jonasnic/Dreimaskin-ELS/HW/ELS_PCB/Freecad/Assembly-Back.step

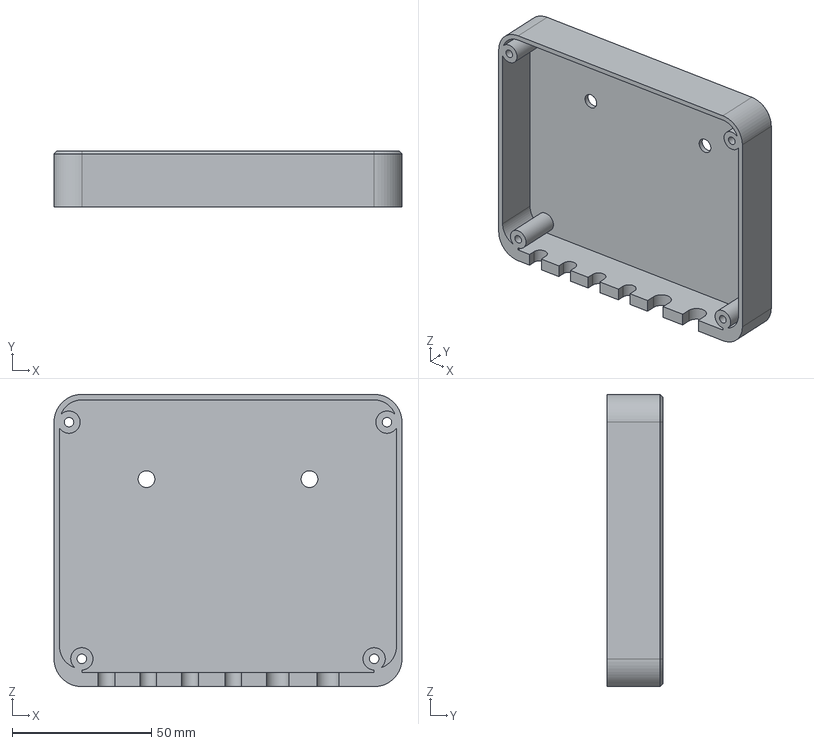
[picture p1: CAD file, 2026-05-08]
HW/ELS_PCB/Freecad/Assembly-Back.step
125.0 x 20.0 x 105.0 mm
