jonasnic/Dreimaskin-ELS/HW/ELS_PCB/Freecad/Assembly.FCStd

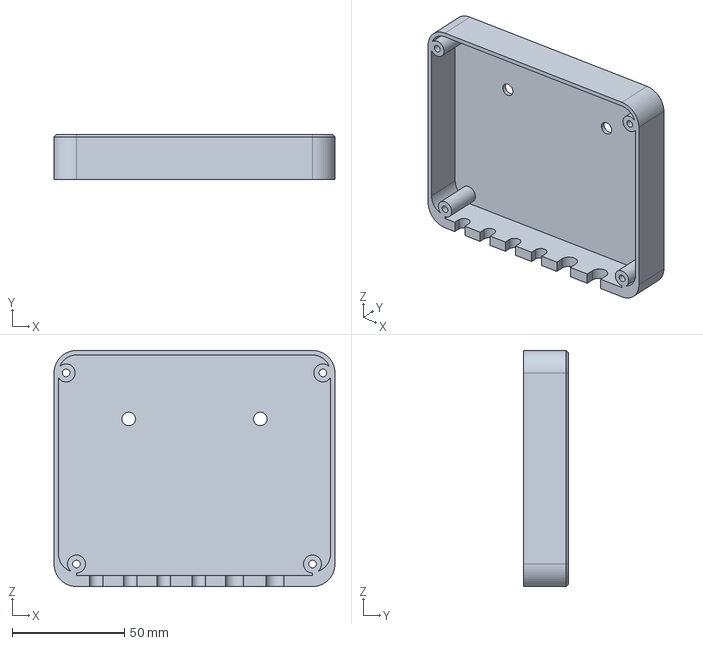
[picture p2: CAD file, 2026-05-08]
HW/ELS_PCB/Freecad/Assembly.FCStd
125.0 x 20.0 x 105.0 mm
