jonasnic/Dreimaskin-ELS/HW/ELS_PCB/Freecad/ELS_project-AssemblyBack001.step

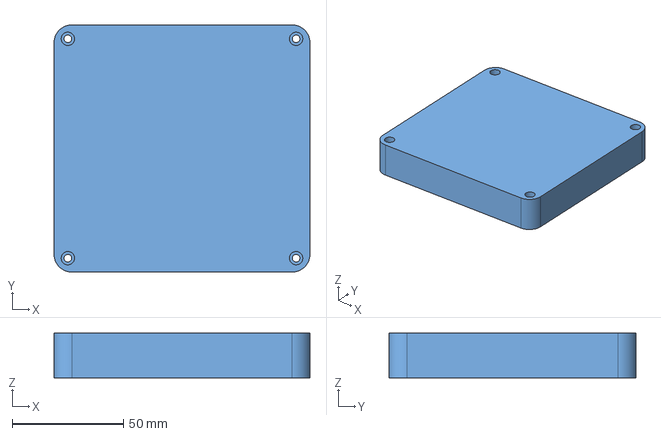
[picture p3: CAD file, 2026-05-03]
HW/ELS_PCB/Freecad/ELS_project-AssemblyBack001.step
115.0 x 111.0 x 20.0 mm
