jonasnic/Dreimaskin-ELS/HW/ELS_PCB/Freecad/ELS_project-AssemblyFrontPanel001.step

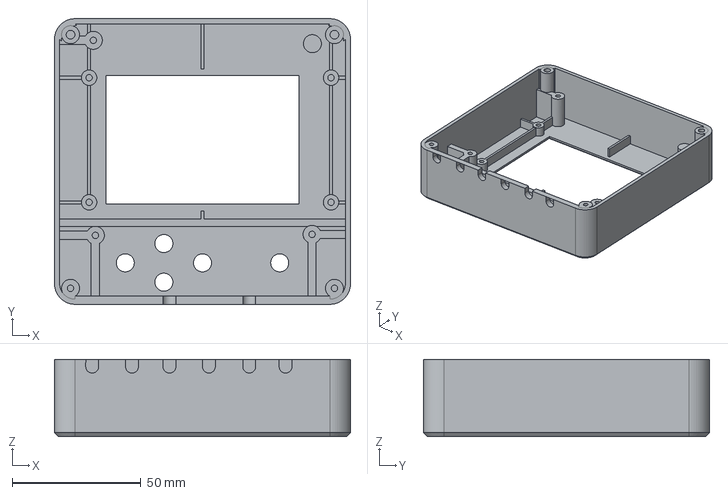
[picture p4: CAD file, 2026-05-03]
HW/ELS_PCB/Freecad/ELS_project-AssemblyFrontPanel001.step
115.0 x 111.0 x 30.0 mm
