jonasnic/Dreimaskin-ELS/HW/ELS_PCB/Freecad/ELS_frontv2.step

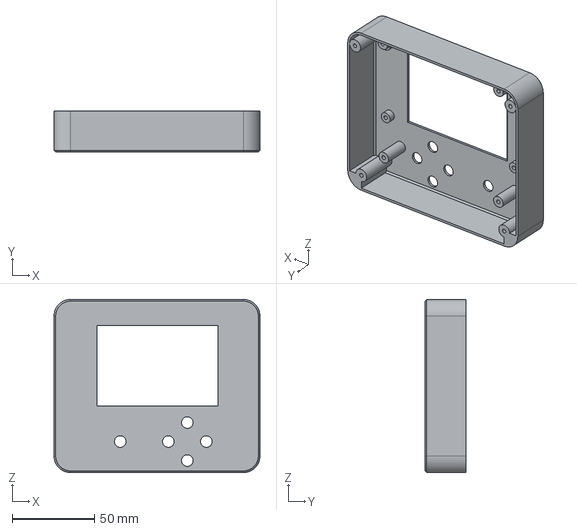
[picture p5: CAD file, 2026-05-08]
HW/ELS_PCB/Freecad/ELS_frontv2.step
125.0 x 25.0 x 105.0 mm
