jonasnic/Dreimaskin-ELS/HW/ELS_PCB/Freecad/ELS_project.FCStd

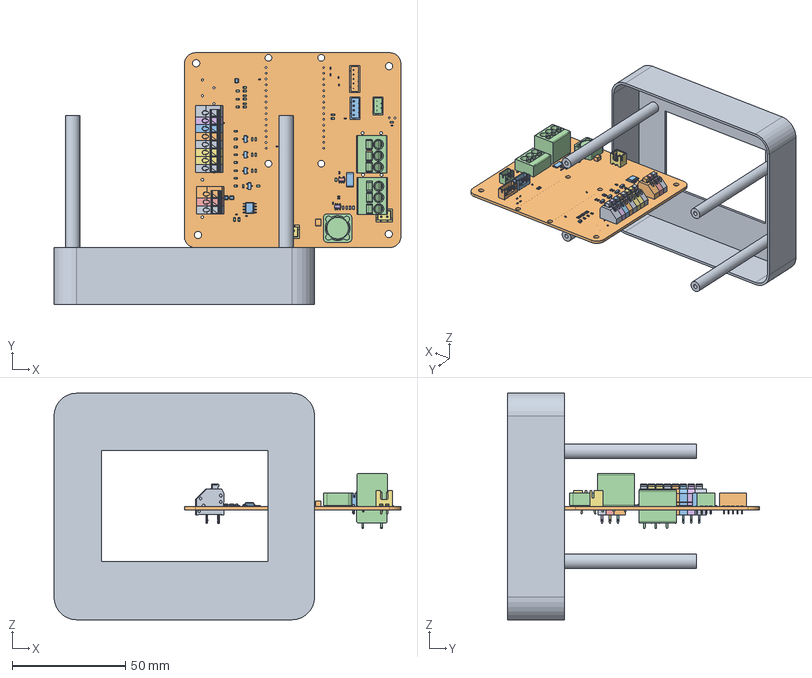
[picture p6: CAD file, 2026-05-08]
HW/ELS_PCB/Freecad/ELS_project.FCStd
153.1 x 111.1 x 100.0 mm
FrontV2
Pcb_7c6a
Q3_SOT-23_f06b826d621a x 4
R6_R_0603_1608Metric_a80c63da43e1 x 31
C1_C_0402_1005Metric_a31eb2e6799d x 12
CONN-TH_8P-P3.50-LS5.10_MX250-3.5-08P-B-GY01-CU-A
CONN-TH_8P-P3.50-LS5.10_MX250-3.5-08P-B-GY01-CU-A001
CONN-TH_8P-P3.50-LS5.10_MX250-3.5-08P-B-GY01-CU-A002
CONN-TH_8P-P3.50-LS5.10_MX250-3.5-08P-B-GY01-CU-A003
CONN-TH_8P-P3.50-LS5.10_MX250-3.5-08P-B-GY01-CU-A004
CONN-TH_8P-P3.50-LS5.10_MX250-3.5-08P-B-GY01-CU-A005
CONN-TH_8P-P3.50-LS5.10_MX250-3.5-08P-B-GY01-CU-A006
CONN-TH_8P-P3.50-LS5.10_MX250-3.5-08P-B-GY01-CU-A007
CONN-TH_8P-P3.50-LS5.10_MX250-3.5-08P-B-GY01-CU-A008
CONN-TH_8P-P3.50-LS5.10_MX250-3.5-08P-B-GY01-CU-A009
CONN-TH_8P-P3.50-LS5.10_MX250-3.5-08P-B-GY01-CU-A010
CONN-TH_8P-P3.50-LS5.10_MX250-3.5-08P-B-GY01-CU-A011
CONN-TH_8P-P3.50-LS5.10_MX250-3.5-08P-B-GY01-CU-A012
CONN-TH_8P-P3.50-LS5.10_MX250-3.5-08P-B-GY01-CU-A013
CONN-TH_8P-P3.50-LS5.10_MX250-3.5-08P-B-GY01-CU-A014
CONN-TH_8P-P3.50-LS5.10_MX250-3.5-08P-B-GY01-CU-A015
CONN-TH_8P-P3.50-LS5.10_MX250-3.5-08P-B-GY01-CU-A016
CONN-TH_8P-P3.50-LS5.10_MX250-3.5-08P-B-GY01-CU-A017
CONN-TH_8P-P3.50-LS5.10_MX250-3.5-08P-B-GY01-CU-A018
CONN-TH_8P-P3.50-LS5.10_MX250-3.5-08P-B-GY01-CU-A019
CONN-TH_8P-P3.50-LS5.10_MX250-3.5-08P-B-GY01-CU-A020
CONN-TH_8P-P3.50-LS5.10_MX250-3.5-08P-B-GY01-CU-A021
CONN-TH_8P-P3.50-LS5.10_MX250-3.5-08P-B-GY01-CU-A022
CONN-TH_8P-P3.50-LS5.10_MX250-3.5-08P-B-GY01-CU-A023
CONN-TH_8P-P3.50-LS5.10_MX250-3.5-08P-B-GY01-CU-A024
CONN-TH_8P-P3.50-LS5.10_MX250-3.5-08P-B-GY01-CU-A025
CONN-TH_8P-P3.50-LS5.10_MX250-3.5-08P-B-GY01-CU-A026
CONN-TH_8P-P3.50-LS5.10_MX250-3.5-08P-B-GY01-CU-A027
CONN-TH_8P-P3.50-LS5.10_MX250-3.5-08P-B-GY01-CU-A028
U5_SOIC-8_L4.9-W3.9-H1.7-LS6.0-P1.27_3aa0a6a722cb
CN1_CONN-TH_3P-P5.00_MX205V-5.0-03P-GN01-CU-A_63676a34b155 x 2
U2_SOT-23-5_063d6bbd4cd2
SOT-23-6_L2.9-W1.6-H1.5-LS2.8-P0.95
SOT-23-6_L2.9-W1.6-H1.5-LS2.8-P0.001
SOT-23-6_L2.9-W1.6-H1.5-LS2.8-P0.002
SOT-23-6_L2.9-W1.6-H1.5-LS2.8-P0.003
SOT-23-6_L2.9-W1.6-H1.5-LS2.8-P0.004
SOT-23-6_L2.9-W1.6-H1.5-LS2.8-P0.005
SOT-23-6_L2.9-W1.6-H1.5-LS2.8-P0.006
SOT-23-6_L2.9-W1.6-H1.5-LS2.8-P0.007
SOT-23-6_L2.9-W1.6-H1.5-LS2.8-P0.008
SOT-23-6_L2.9-W1.6-H1.5-LS2.8-P0.009
SOT-23-6_L2.9-W1.6-H1.5-LS2.8-P0.010
SOT-23-6_L2.9-W1.6-H1.5-LS2.8-P0.011
SOT-23-6_L2.9-W1.6-H1.5-LS2.8-P0.012
SOT-23-6_L2.9-W1.6-H1.5-LS2.8-P0.013
SOT-23-6_L2.9-W1.6-H1.5-LS2.8-P0.014
SOT-23-6_L2.9-W1.6-H1.5-LS2.8-P0.015
SOT-23-6_L2.9-W1.6-H1.5-LS2.8-P0.016
SOT-23-6_L2.9-W1.6-H1.5-LS2.8-P0.017
SOT-23-6_L2.9-W1.6-H1.5-LS2.8-P0.018
SOT-23-6_L2.9-W1.6-H1.5-LS2.8-P0.019
C13_C_1210_3225Metric_c6d2dd8fc412
SOT-363-6P_L2.0-W1.3-H1.1-LS2.0-P0.65 x 3
SOT-363-6P_L2.0-W1.3-H1.1-LS2.0-P0.001 x 3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
