jonasnic/Dreimaskin-ELS/HW/ELS_PCB/Freecad/nextion_simp.FCStd

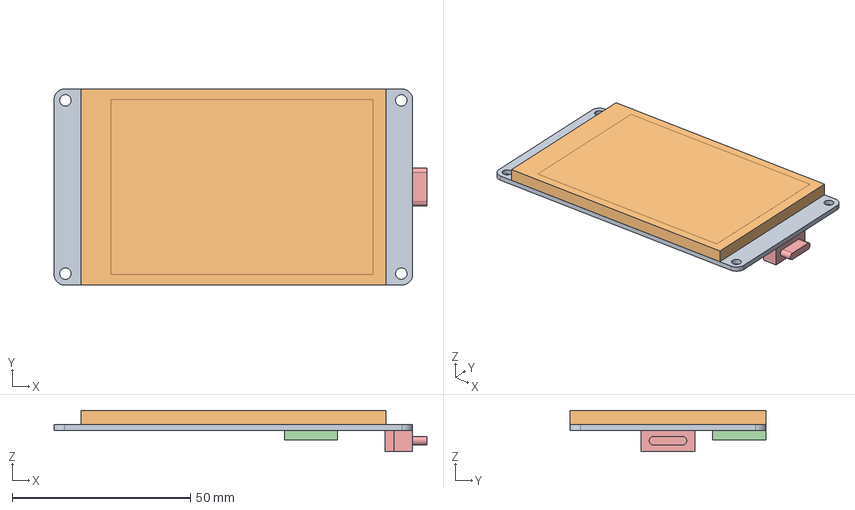
[picture p7: CAD file, 2026-05-08]
HW/ELS_PCB/Freecad/nextion_simp.FCStd
104.5 x 54.9 x 11.6 mm
PCB001
LCD001
ShapeString003
SDcard
connector
ShapeString001
ShapeString002
