jonasnic/Dreimaskin-ELS/HW/ELS_PCB/Freecad/encoder2.FCStd

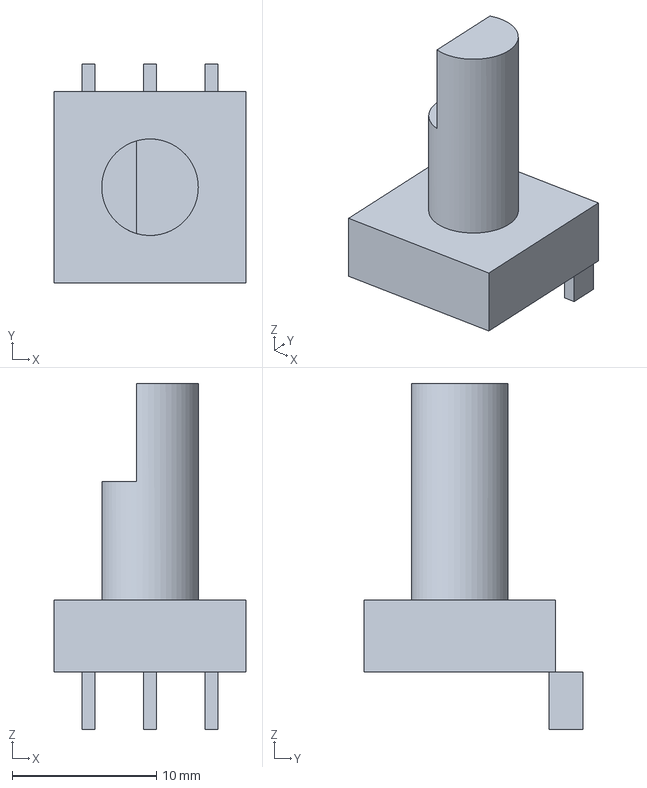
[picture p8: CAD file, 2026-05-03]
HW/ELS_PCB/Freecad/encoder2.FCStd
13.3 x 15.2 x 24.0 mm
