jonasnic/Dreimaskin-ELS/HW/ELS_PCB/Freecad/button.FCStd

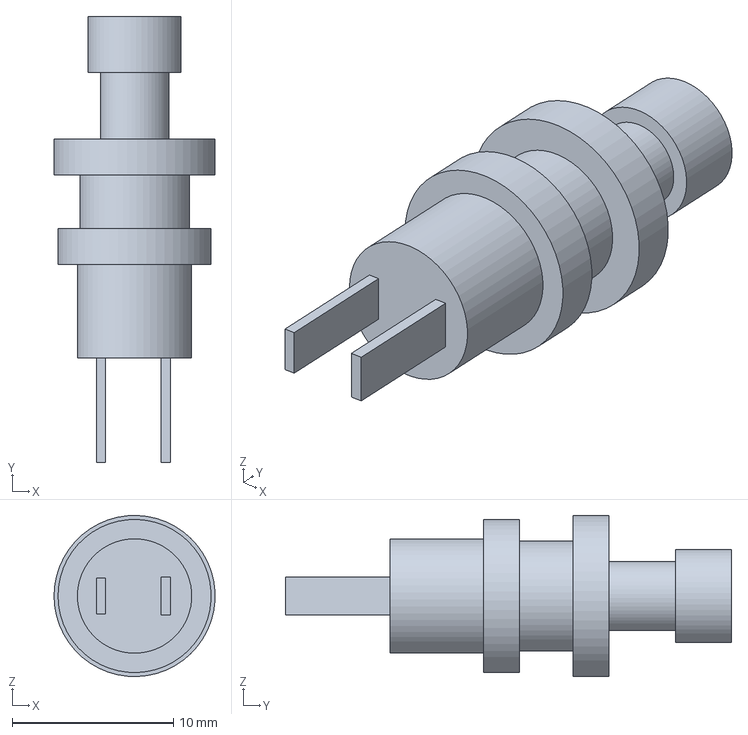
[picture p9: CAD file, 2026-05-03]
HW/ELS_PCB/Freecad/button.FCStd
9.99 x 27.7 x 10.00 mm
