jonasnic/Dreimaskin-ELS/HW/ELS_PCB/ELS_project.kicad_pcb

## KiCad design HW/ELS_PCB/ELS_project.kicad_pcb (2026-05-03)

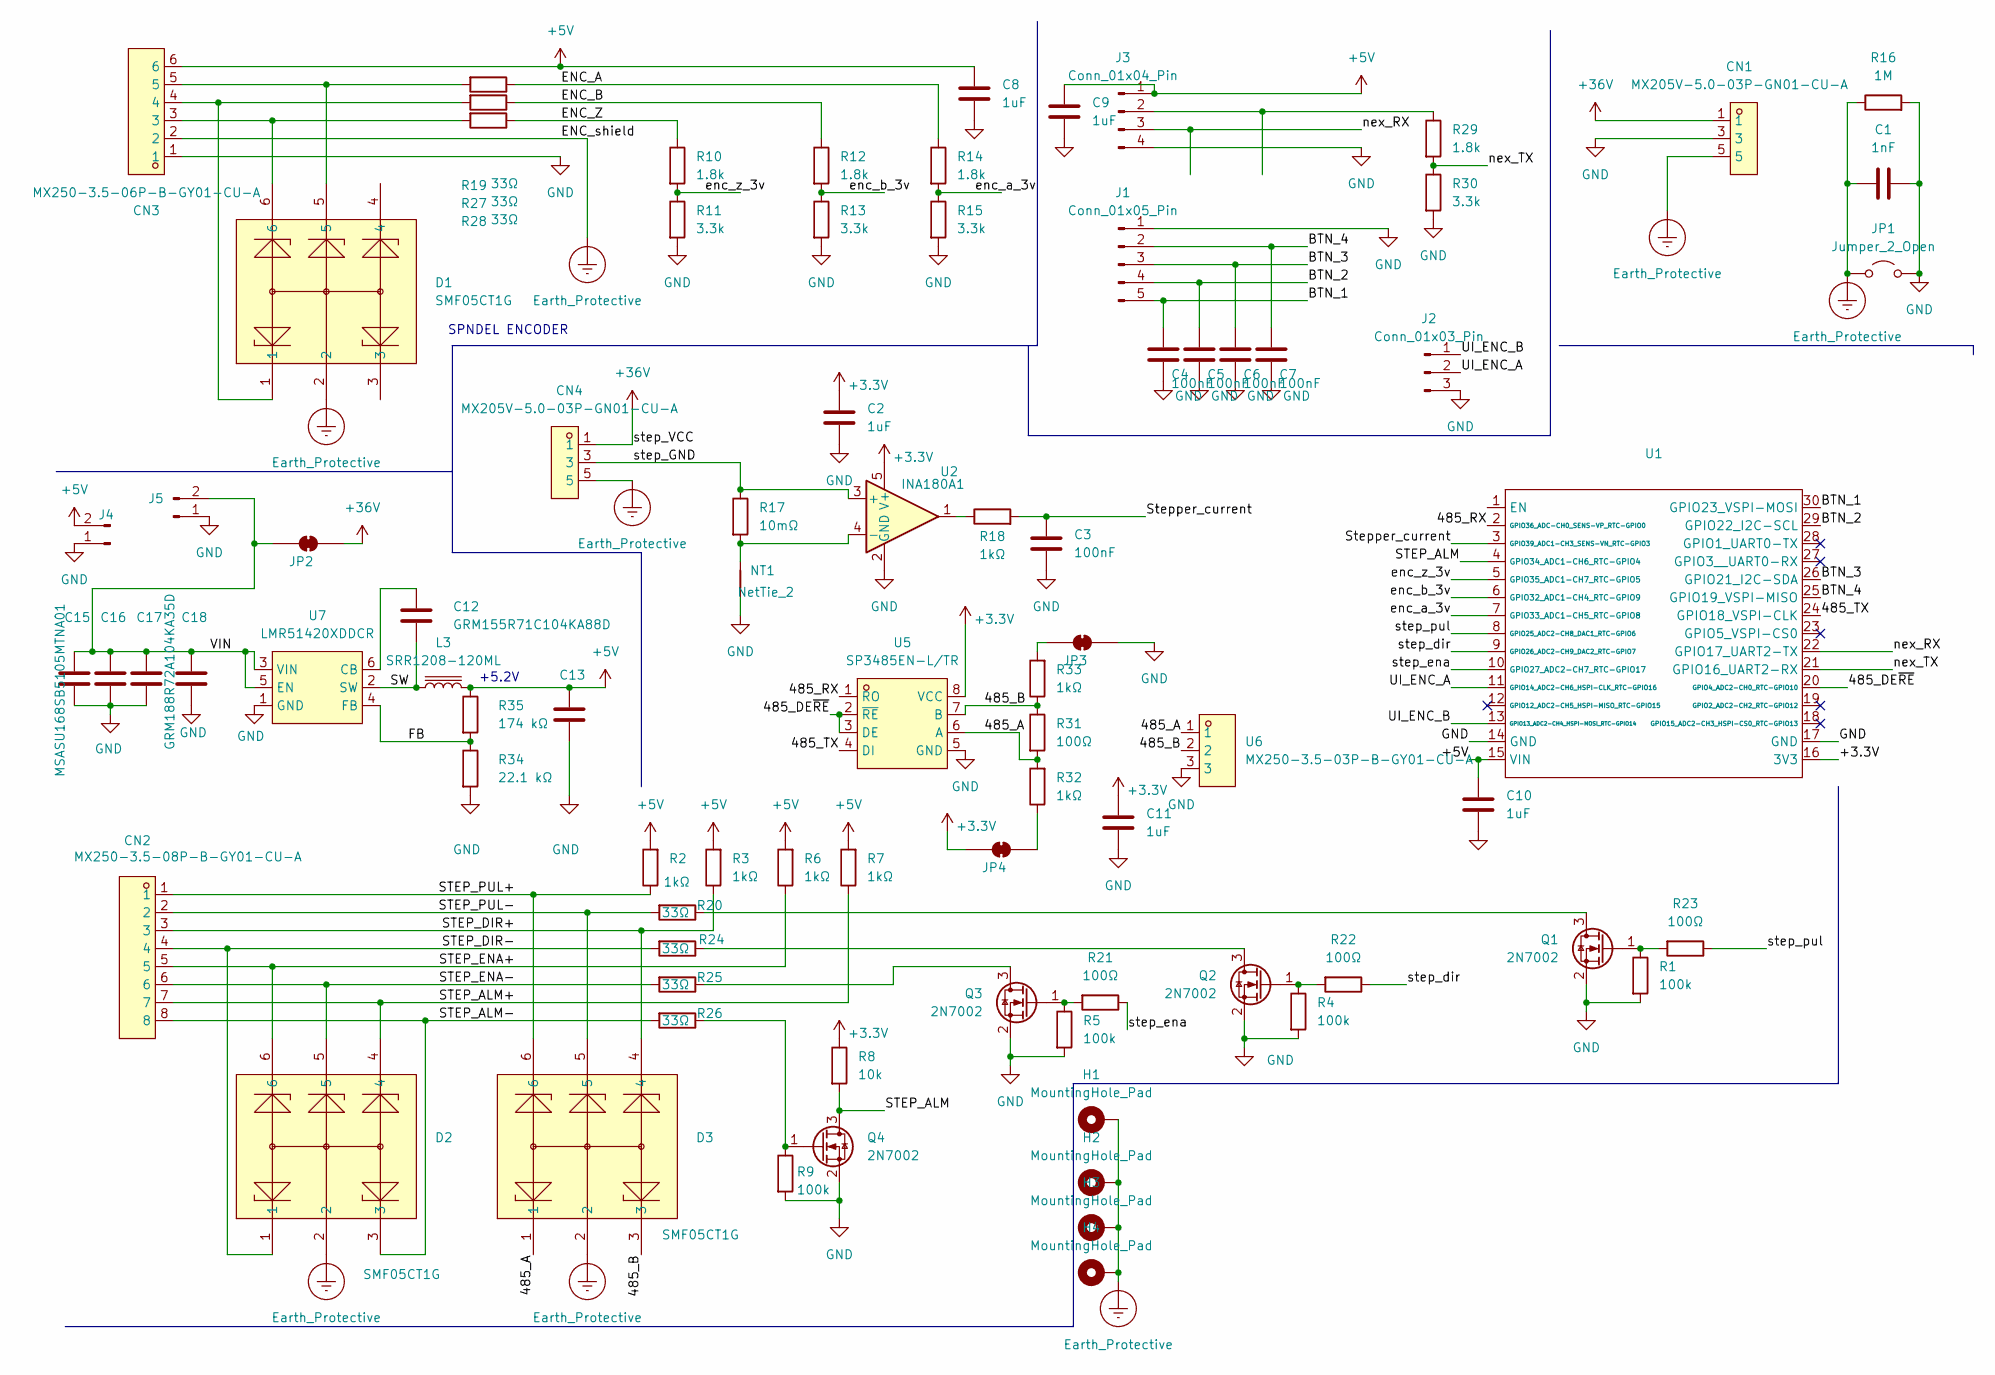
[picture p10: schematic ELS_project.kicad_sch]

Parts:
C1: 1nF; C_0402_1005Metric; LCSC C1523
C2, C8, C9, C10, C11: 1uF; C_0402_1005Metric; LCSC C52923
C3, C4, C5, C6, C7: 100nF; C_0402_1005Metric; LCSC C1525
C12: GRM155R71C104KA88D; C_0402_1005Metric
C13: GRM32ER61C476KE15L; C_1210_3225Metric
C15, C16, C17: MSASU168SB5105MTNA01; C_0603_1608Metric
C18: GRM188R72A104KA35D; C_0603_1608Metric
CN1, CN4: MX205V-5.0-03P-GN01-CU-A; CONN-TH_3P-P5.00_MX205V-5.0-03P-GN01-CU-A; MPN MX205V-5.0-03P-GN01-Cu-A; LCSC Part C7471323
CN2: MX250-3.5-08P-B-GY01-CU-A; CONN-TH_8P-P3.50-LS5.10_MX250-3.5-08P-B-GY01-CU-A; MPN MX250-3.5-08P-B-GY01-Cu-A; LCSC Part C7470122
CN3: MX250-3.5-06P-B-GY01-CU-A; CONN-TH_6P-P3.50_MX250-3.5-06P-B-GY01-CU-A; MPN MX250-3.5-06P-B-GY01-Cu-A; LCSC Part C7470120
D1, D2, D3: SMF05CT1G; SOT-363_L2.0-W1.3-P0.65-LS2.1-BR; MPN SMF05CT1G; LCSC Part C15879
H1, H2, H3, H4: MountingHole_Pad; MountingHole_3.2mm_M3_Pad_TopOnly
J1: Conn_01x05_Pin; JST_PH_B5B-PH-K_1x05_P2.00mm_Vertical
J2: Conn_01x03_Pin; JST_PH_B3B-PH-K_1x03_P2.00mm_Vertical
J3: Conn_01x04_Pin; JST_PH_B4B-PH-K_1x04_P2.00mm_Vertical
J4, J5: Conn_01x02_Pin; JST_XH_B2B-XH-AM_1x02_P2.50mm_Vertical
JP1: Jumper_2_Open; TestPoint_2Pads_Pitch2.54mm_Drill0.8mm
JP2, JP3, JP4: SolderJumper_2_Bridged; SolderJumper-2_P1.3mm_Bridged_Pad1.0x1.5mm
L3: SRR1208-120ML; L_Bourns_SRR1208_12.7x12.7mm
NT1: NetTie_2; NetTie-2_SMD_Pad2.0mm
Q1, Q2, Q3, Q4: 2N7002; SOT-23; LCSC C8545
R1, R4, R5, R9: 100k; R_0603_1608Metric; LCSC C25803
R2, R3, R6, R7, R18, R32, R33: 1kΩ; R_0603_1608Metric; LCSC C21190
R8: 10k; R_0603_1608Metric; LCSC C25803
R10, R12, R14, R29: 1.8k; R_0603_1608Metric; LCSC C4177
R11, R13, R15, R30: 3.3k; R_0603_1608Metric; LCSC C22978
R16: 1M; R_0603_1608Metric; LCSC C22935
R17: 10mΩ; R_2512_6332Metric; LCSC C5121042
R19, R20, R24, R25, R26, R27, R28: 33Ω; R_0603_1608Metric; LCSC C23140
R21, R22, R23: 100Ω; R_0603_1608Metric; LCSC C22775
R31: 100Ω; R_0402_1005Metric; LCSC C17437
R34: 22.1 kΩ; R_0402_1005Metric
R35: 174 kΩ; R_0402_1005Metric
U1: ESP32-DEVKIT-V1_30pin
U2: INA180A1; SOT-23-5; LCSC C48533472
U5: SP3485EN-L/TR; SOIC-8_L5.0-W4.0-P1.27-LS6.0-BL; MPN SP3485EN-L/TR; LCSC Part C8963
U6: MX250-3.5-03P-B-GY01-CU-A; CONN-TH_3P-P3.50_MX250-3.5-03P-B-GY01-CU-A; MPN MX250-3.5-03P-B-GY01-Cu-A; LCSC Part C7470117
U7: LMR51420XDDCR; SOT-23-6_L2.9-W1.6-P0.95-LS2.8-BL; MPN LMR51420XDDCR; LCSC Part C5246146

Connections:
+3.3V: C2.2, C11.2, JP4.2 (B), R8.1, U1.16 (3V3), U2.5 (V+), U5.8 (VCC)
+5V: C8.2, C9.2, C10.2, C13.1, CN3.6, J3.1, J4.2, L3.2, R2.2, R3.2, R6.2, R7.2, R35.1, U1.15 (VIN)
+36V: CN1.1, CN1.2, CN4.1, CN4.2, JP2.1 (A)
/485_A: D3.1, R31.2, R32.2, U5.6 (A), U6.1
/485_B: D3.3, R31.1, R33.1, U5.7 (B), U6.2
/485_DE~RE: U1.20 (GPIO4_ADC2-CH0_RTC-GPIO10), U5.2 (~RE), U5.3 (DE)
/485_RX: U1.2 (GPIO36_ADC-CH0_SENS-VP_RTC-GPIO0), U5.1 (RO)
/485_TX: U1.24 (GPIO18_VSPI-CLK), U5.4 (DI)
/BTN_1: C4.2, J1.5, U1.30 (GPIO23_VSPI-MOSI)
/BTN_2: C5.2, J1.4, U1.29 (GPIO22_I2C-SCL)
/BTN_3: C6.2, J1.3, U1.26 (GPIO21_I2C-SDA)
/BTN_4: C7.2, J1.2, U1.25 (GPIO19_VSPI-MISO)
/ENC_A: R14.1, R19.1
/ENC_B: R12.1, R27.1
/ENC_Z: R10.1, R28.1
/FB: R34.1, R35.2, U7.4 (FB)
/STEP_ALM: Q4.3 (D), R8.2, U1.4 (GPIO34_ADC1-CH6_RTC-GPIO4)
/STEP_ALM+: CN2.7, D2.4, R7.1
/STEP_ALM-: CN2.8, D2.3, R26.2
/STEP_DIR+: CN2.3, D3.4, R3.1
/STEP_DIR-: CN2.4, D2.1, R24.2
/STEP_ENA+: CN2.5, D2.6, R6.1
/STEP_ENA-: CN2.6, D2.5, R25.2
/STEP_PUL+: CN2.1, D3.6, R2.1
/STEP_PUL-: CN2.2, D3.5, R20.2
/SW: C12.2, L3.1, U7.2 (SW)
/Stepper_current: C3.2, R18.2, U1.3 (GPIO39_ADC1-CH3_SENS-VN_RTC-GPIO3)
/UI_ENC_A: J2.2, U1.11 (GPIO14_ADC2-CH6_HSPI-CLK_RTC-GPIO16)
/UI_ENC_B: J2.1, U1.13 (GPIO13_ADC2-CH4_HSPI-MOSI_RTC-GPIO14)
/VIN: C15.1, C16.1, C17.1, C18.1, J5.2, JP2.2 (B), U7.3 (VIN), U7.5 (EN)
/enc_a_3v: R14.2, R15.1, U1.7 (GPIO33_ADC1-CH5_RTC-GPIO8)
/enc_b_3v: R12.2, R13.1, U1.6 (GPIO32_ADC1-CH4_RTC-GPIO9)
/enc_z_3v: R10.2, R11.1, U1.5 (GPIO35_ADC1-CH7_RTC-GPIO5)
/nex_RX: J3.3, U1.22 (GPIO17_UART2-TX)
/nex_TX: R29.2, R30.1, U1.21 (GPIO16_UART2-RX)
/step_GND: CN4.3, CN4.4, R17.1, U2.3 (+)
/step_dir: R22.1, U1.9 (GPIO26_ADC2-CH9_DAC2_RTC-GPIO7)
/step_ena: R21.1, U1.10 (GPIO27_ADC2-CH7_RTC-GPIO17)
/step_pul: R23.1, U1.8 (GPIO25_ADC2-CH8_DAC1_RTC-GPIO6)
Earth_Protective: C1.1, CN1.5, CN1.6, CN3.2, CN4.5, CN4.6, D1.2, D2.2, D3.2, H1.1 (1_1), H2.1 (1_1), H3.1 (1_1), H4.1 (1_1), JP1.1 (A), R16.1
GND: C1.2, C2.1, C3.1, C4.1, C5.1, C6.1, C7.1, C8.1, C9.1, C10.1, C11.1, C13.2, C15.2, C16.2, C17.2, C18.2, CN1.3, CN1.4, CN3.1, J1.1, J2.3, J3.4, J4.1, J5.1, JP1.2 (B), JP3.1 (A), NT1.1, Q1.2 (S), Q2.2 (S), Q3.2 (S), Q4.2 (S), R1.2, R4.2, R5.2, R9.2, R11.2, R13.2, R15.2, R16.2, R30.2, R34.2, U1.14 (GND), U1.17 (GND), U2.2 (GND), U5.5 (GND), U6.3, U7.1 (GND)
unnamed: CN3.3, D1.6, R28.2
unnamed: CN3.4, D1.1, R27.2
unnamed: CN3.5, D1.5, R19.2
unnamed: J3.2, R29.1
unnamed: JP3.2 (B), R33.2
unnamed: JP4.1 (A), R32.1
unnamed: Q1.3 (D), R20.1
unnamed: Q1.1 (G), R1.1, R23.2
unnamed: Q2.3 (D), R24.1
unnamed: Q2.1 (G), R4.1, R22.2
unnamed: Q3.3 (D), R25.1
unnamed: Q3.1 (G), R5.1, R21.2
unnamed: Q4.1 (G), R9.1, R26.1
unnamed: R18.1, U2.1
unnamed: NT1.2, R17.2, U2.4 (-)
unnamed: C12.1, U7.6 (CB)

Notes on the sheet:
+5.2V
SPNDEL ENCODER

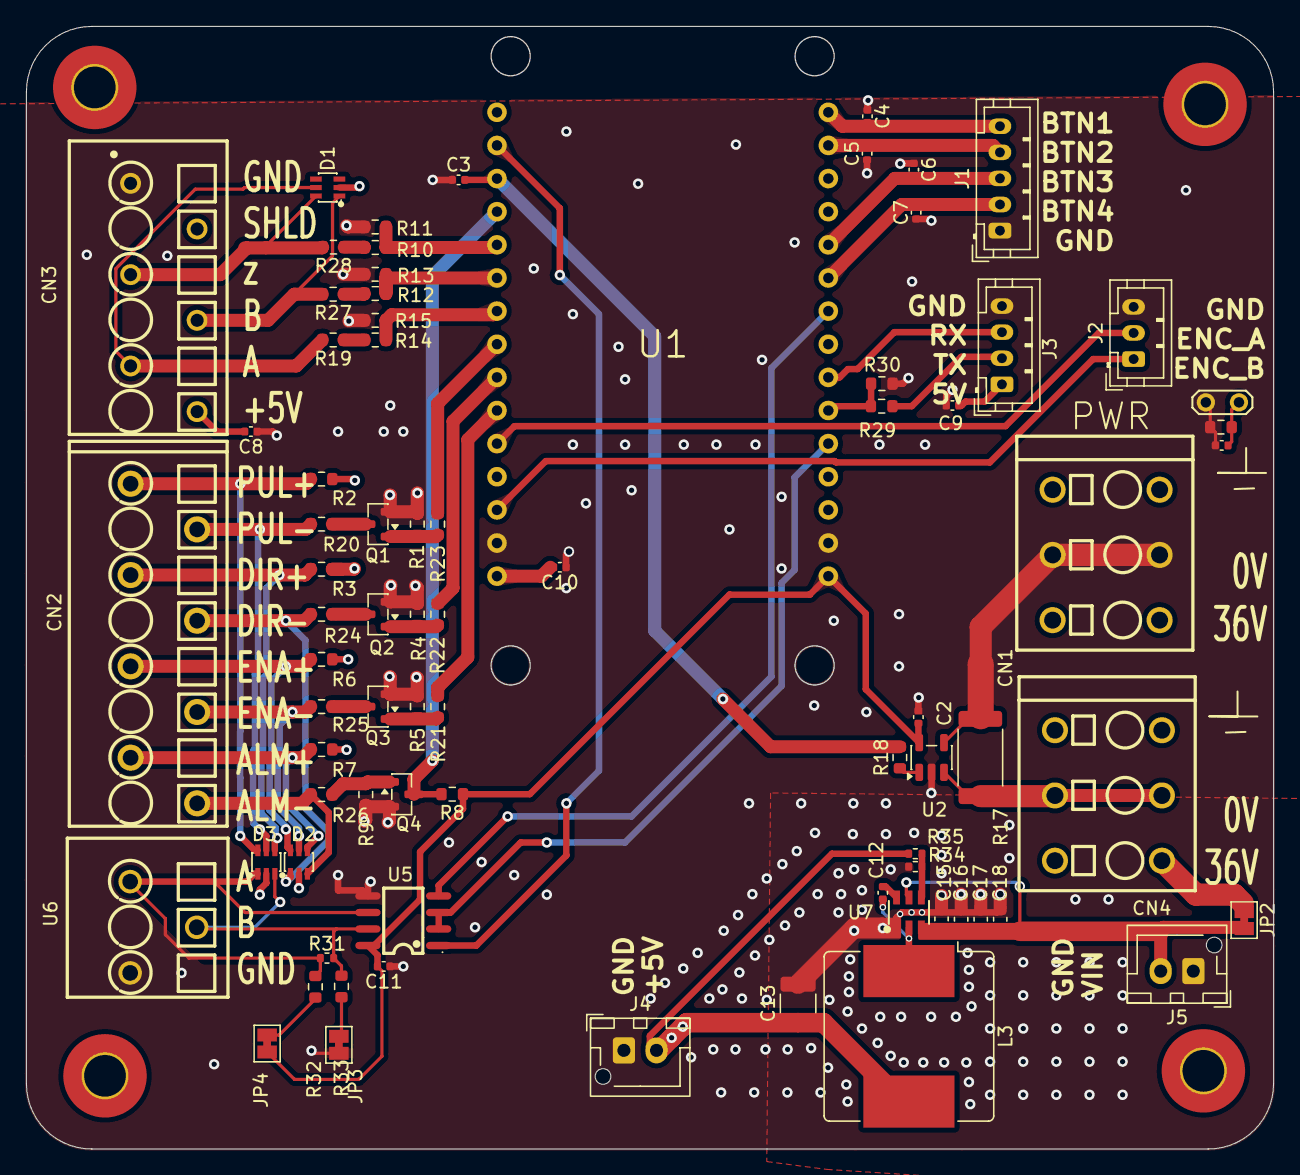
[picture p11: board ELS_project.kicad_pcb from above]

Board: 4 copper layers, 95.6 x 86.1 mm, 83 parts (0 on the bottom side), 57 nets.
