jonasnic/Dreimaskin-ELS/SW/ESP_ELS/src/common/mqtt_manager.cpp

#include "mqtt_manager.h"

#include "common/queues.h"
#include <PubSubClient.h>
#include <WiFi.h>
#include <math.h>
#include <stdlib.h>

#ifndef MQTT_BROKER
#define MQTT_BROKER "192.168.1.100"
#endif

#ifndef MQTT_PORT
#define MQTT_PORT 1883
#endif

#ifndef MQTT_CLIENT_ID
#define MQTT_CLIENT_ID "dreimaskin_els"
#endif

namespace {

    WiFiClient wifiClient;
    PubSubClient mqttClient(wifiClient);
    bool mqttInitialized = false;
    TickType_t lastReconnectAttempt = 0;

    constexpr const char *kCmdTopic = "dreimaskin_els/command";
    constexpr const char *kCmdModeTopic = "dreimaskin_els/command/mode";
    constexpr const char *kCmdPitchTopic = "dreimaskin_els/command/pitch";
    // topics to subscribe to for commands; must be kept in sync with mqttCallback() parsing logic
    constexpr const char *kCmdTopics[] = {
        kCmdTopic,
        kCmdModeTopic,
        kCmdPitchTopic};

    constexpr const char *kStatusPosTopic = "dreimaskin_els/status/position";
    constexpr const char *kStatusSpeedTopic = "dreimaskin_els/status/speed";
    constexpr const char *kStatusTargetTopic = "dreimaskin_els/status/target";
    constexpr const char *kStatusDistanceTopic = "dreimaskin_els/status/distance_to_target";
    constexpr const char *kStatusModeTopic = "dreimaskin_els/status/mode";
    constexpr const char *kStatusLoopTimeTopic = "dreimaskin_els/status/loop_time_us";
    constexpr const char *kStatusBatchTimeTopic = "dreimaskin_els/status/batch_time_us";
    constexpr const char *kStatusAlarmTopic = "dreimaskin_els/status/alarm";
    constexpr const char *kStatusAliveTopic = "dreimaskin_els/status";
    constexpr TickType_t kReconnectInterval = pdMS_TO_TICKS(3000);

    bool parseTargetCommand(const char *text, int32_t *target) {
        if (text == nullptr || target == nullptr) {
            return false;
        }

        char *endPtr = nullptr;
        long value = strtol(text, &endPtr, 10);
        if (endPtr == text || *endPtr != '\0') {
            return false;
        }

        *target = (int32_t)value;
        return true;
    }

    bool parseModeCommand(const char *text, MotionMode *mode) {
        if (text == nullptr || mode == nullptr) {
            return false;
        }

        if (strcmp(text, "position") == 0 || strcmp(text, "move") == 0) {
            *mode = MOTION_MODE_POSITION;
            return true;
        }

        if (strcmp(text, "follow") == 0) {
            *mode = MOTION_MODE_FOLLOW;
            return true;
        }

        return false;
    }

    bool parseStepperEnableCommand(const char *text, bool *enable) {
        if (text == nullptr || enable == nullptr) {
            return false;
        }

        if (strcmp(text, "stepper enable") == 0 || strcmp(text, "enable stepper") == 0) {
            *enable = true;
            return true;
        }

        if (strcmp(text, "stepper disable") == 0 || strcmp(text, "disable stepper") == 0) {
            *enable = false;
            return true;
        }

        return false;
    }

    bool parsePitchCommand(const char *text, int32_t *pitch_1e5_mm_per_rev) {
        if (text == nullptr || pitch_1e5_mm_per_rev == nullptr) {
            return false;
        }

        char *endPtr = nullptr;
        double value = strtod(text, &endPtr);
        if (endPtr == text || *endPtr != '\0') {
            return false;
        }

        const double scaled = value * 100000.0;

        if (!isfinite(value)) {
            return false;
        }

        *pitch_1e5_mm_per_rev = (int32_t)round(scaled);
        return true;
    }

    bool queueMotionCommand(const MotionCommand &cmd) {
        return xQueueSend(motionQueue, &cmd, pdMS_TO_TICKS(10)) == pdTRUE;
    }

    void mqttCallback(char *topic, byte *payload, unsigned int length) {
        char cmdStr[32] = {0};
        if (length >= sizeof(cmdStr) - 1) {
            return;
        }

        strncpy(cmdStr, (const char *)payload, length);
        cmdStr[length] = '\0';

        if (strcmp(topic, kCmdTopic) == 0) {
            int32_t target = 0;
            bool enableStepper = false;
            if (parseStepperEnableCommand(cmdStr, &enableStepper)) {
                MotionCommand cmd = {};
                cmd.cmd = MOTION_CMD_SET_STEPPER_ENABLE;
                cmd.stepper_enabled = enableStepper ? 1 : 0;

                if (queueMotionCommand(cmd)) {
                    Serial.printf("[MQTT] Stepper command received: %s\n", enableStepper ? "enable" : "disable");
                } else {
                    Serial.println("[MQTT] Failed to queue stepper command");
                }
            } else if (parseTargetCommand(cmdStr, &target)) {
                MotionCommand cmd = {};
                cmd.cmd = MOTION_CMD_SET_TARGET;
                cmd.target = target;
                cmd.speed = 2000;

                if (queueMotionCommand(cmd)) {
                    publishTargetStatus(target);
                    Serial.printf("[MQTT] Command received: target %ld\n", target);
                } else {
                    Serial.println("[MQTT] Failed to queue target command");
                }
            }
        } else if (strcmp(topic, kCmdModeTopic) == 0) {
            MotionMode mode;
            if (parseModeCommand(cmdStr, &mode)) {
                MotionCommand cmd = {};
                cmd.cmd = MOTION_CMD_SET_MODE;
                cmd.mode = (uint8_t)mode;

                if (queueMotionCommand(cmd)) {
                    publishMotionMode(mode);
                    Serial.printf("[MQTT] Mode command received: %s\n", cmdStr);
                } else {
                    Serial.println("[MQTT] Failed to queue mode command");
                }
            }
        } else if (strcmp(topic, kCmdPitchTopic) == 0) {
            int32_t pitch_1e5_mm_per_rev = 0;
            if (parsePitchCommand(cmdStr, &pitch_1e5_mm_per_rev)) {
                MotionCommand cmd = {};
                cmd.cmd = MOTION_CMD_SET_PITCH;
                cmd.pitch_1e5_mm_per_rev = pitch_1e5_mm_per_rev;

                if (queueMotionCommand(cmd)) {
                    Serial.printf("[MQTT] Pitch command received: %s mm/rev\n", cmdStr);
                } else {
                    Serial.println("[MQTT] Failed to queue pitch command");
                }
            } else {
                Serial.printf("[MQTT] Invalid pitch command: %s\n", cmdStr);
            }
        }
    }

    bool connectToMQTT() {
        if (WiFi.status() != WL_CONNECTED) {
            return false;
        }

        if (mqttClient.connected()) {
            return true;
        }

        Serial.printf("[MQTT] Connecting to %s:%d\n", MQTT_BROKER, MQTT_PORT);

        // Connect with last will: publish "DEAD" if device disconnects unexpectedly
        String clientId = MQTT_CLIENT_ID;
        static char id_suffix_counter = 0;
        clientId += "_";
        clientId += (char)('A' + (id_suffix_counter++ % 26)); // Append a letter to ensure unique client ID if multiple devices use the same code

        if (mqttClient.connect(clientId.c_str(), kStatusAliveTopic, 0, true, "DEAD")) {
            Serial.println("[MQTT] Connected to broker");

            // Publish ALIVE message to indicate successful connection
            mqttClient.publish(kStatusAliveTopic, "ALIVE", true);
            Serial.printf("[MQTT] Published ALIVE to %s\n", kStatusAliveTopic);

            for(auto &subTopic : kCmdTopics) {
                mqttClient.subscribe(subTopic);
                Serial.printf("[MQTT] Subscribed to %s\n", subTopic);
            }
            return true;
        } else {
            Serial.printf("[MQTT] Failed to connect, rc=%d\n", mqttClient.state());
            return false;
        }
    }

    bool ensureMqttInitialized() {
        if (mqttInitialized) {
            return true;
        }

        mqttClient.setServer(MQTT_BROKER, MQTT_PORT);
        mqttClient.setCallback(mqttCallback);
        mqttClient.setKeepAlive(15);
        mqttClient.setSocketTimeout(2);
        mqttInitialized = true;
        lastReconnectAttempt = 0;

        Serial.println("[MQTT] Manager initialized (UI task driven)");
        return true;
    }

} // namespace

void startMQTTTask(UBaseType_t priority, BaseType_t core) {
    (void)priority;
    (void)core;

    (void)ensureMqttInitialized();
}

void mqttServiceTick() {
    if (!ensureMqttInitialized()) return;
    if (WiFi.status() != WL_CONNECTED) return;

    if (!mqttClient.connected()) {
        TickType_t now = xTaskGetTickCount();
        if ((now - lastReconnectAttempt) >= kReconnectInterval) {
            lastReconnectAttempt = now;
            connectToMQTT();
        }
    } else {
        mqttClient.loop();
    }
}

bool isMQTTConnected() {
    return mqttClient.connected();
}

void publishMotionData(MotionData data) {
    if (!mqttClient.connected()) {
        return;
    }

    char buf[16];
    switch (data.type) {
    case POSITION:
        snprintf(buf, sizeof(buf), "%ld", data.value.position);
        mqttClient.publish(kStatusPosTopic, buf);
        break;
    case SPEED:
        snprintf(buf, sizeof(buf), "%ld", data.value.speed);
        mqttClient.publish(kStatusSpeedTopic, buf);
        break;
    case DIRECTION:
        mqttClient.publish(kStatusModeTopic, data.value.direction ? "Positive" : "Negative");
        break;
    case DISTANCE_TO_TARGET:
        snprintf(buf, sizeof(buf), "%ld", data.value.distance_to_target);
        mqttClient.publish(kStatusDistanceTopic, buf);
        break;
    case TARGET_POSITION:
        snprintf(buf, sizeof(buf), "%ld", data.value.position);
        mqttClient.publish(kStatusTargetTopic, buf);
        break;
    case LOOP_TIME_US:
        snprintf(buf, sizeof(buf), "%lu", (unsigned long)data.value.loop_time_us);
        mqttClient.publish(kStatusLoopTimeTopic, buf);
        break;
    case BATCH_TIME_US:
        snprintf(buf, sizeof(buf), "%lu", (unsigned long)data.value.batch_time_us);
        mqttClient.publish(kStatusBatchTimeTopic, buf);
        break;
    case ALARM:
        mqttClient.publish(kStatusAlarmTopic, data.value.alarm ? "ALARM" : "OK", true);
        break;

    default:
        break;
    }
}

void publishTargetStatus(int32_t target) {
    if (!mqttClient.connected()) {
        return;
    }

    char buf[16];
    snprintf(buf, sizeof(buf), "%ld", target);
    mqttClient.publish(kStatusTargetTopic, buf, true);
}

void publishMotionMode(MotionMode mode) {
    if (!mqttClient.connected()) {
        return;
    }

    const char *modeText = (mode == MOTION_MODE_FOLLOW) ? "follow" : "position";
    mqttClient.publish(kStatusModeTopic, modeText, true);
}
