jonasnic/Dreimaskin-ELS/SW/ESP_ELS/src/common/queues.cpp

#include "queues.h"

QueueHandle_t motionQueue;
QueueHandle_t UIQueue;

void initQueues()
{
    motionQueue = xQueueCreate(10, sizeof(MotionCommand));
    UIQueue = xQueueCreate(1, sizeof(MotionData));
    
}
