jonasnic/Dreimaskin-ELS/SW/ESP_ELS/include/bitpattern_table.h

#pragma once

#include <stdint.h>

constexpr uint64_t kBitPatterns[64] = {
    0x8000000000000000ULL,
    0x8000000080000000ULL,
    0x8000040000100000ULL,
    0x8000800080008000ULL,
    0x8004002002001000ULL,
    0x8010040080100400ULL,
    0x8040201004020100ULL,
    0x8080808080808080ULL,
    0x8102040808102040ULL,
    0x8204102082041020ULL,
    0x8208410410410820ULL,
    0x8410841084108410ULL,
    0x8421084221084210ULL,
    0x8442211084422110ULL,
    0x8844442222111108ULL,
    0x8888888888888888ULL,
    0x8891112222444488ULL,
    0x8912244889122448ULL,
    0x9124489224891244ULL,
    0x9224922492249224ULL,
    0x9249249224924924ULL,
    0x9249492492494924ULL,
    0x92925249492524a4ULL,
    0x9494949494949494ULL,
    0x94a529294a4a5294ULL,
    0xa5294a52a5294a52ULL,
    0xa54a54a94a952952ULL,
    0xa552a552a552a552ULL,
    0xa9552aa552aa554aULL,
    0xaa55552aaa55552aULL,
    0xaaaa555555552aaaULL,
    0xaaaaaaaaaaaaaaaaULL,
    0xaaaad5555555aaaaULL,
    0xaad555aaaad555aaULL,
    0xad55aab556aad55aULL,
    0xad5aad5aad5aad5aULL,
    0xb56ad6ad5ab5ab56ULL,
    0xb5ad5ad6b5ad5ad6ULL,
    0xb5b5ad6b6b5ad6d6ULL,
    0xb6b6b6b6b6b6b6b6ULL,
    0xb6dadb5b6d6dadb6ULL,
    0xb6db6db6b6db6db6ULL,
    0xdb6db6db6db6db6dULL,
    0xdb6ddb6ddb6ddb6dULL,
    0xdb76edbb6edbb76dULL,
    0xdbb776eddbb776edULL,
    0xddbbbb77776eeeddULL,
    0xddddddddddddddddULL,
    0xddeeeef777bbbbddULL,
    0xdeef7bbddeef7bbdULL,
    0xdef7bdef7bdef7bdULL,
    0xef7bef7bef7bef7bULL,
    0xefbef7df7df7befbULL,
    0xefdf7dfbefdf7dfbULL,
    0xf7efdfbf7efdfbf7ULL,
    0xf7f7f7f7f7f7f7f7ULL,
    0xfbfdfeff7fbfdfefULL,
    0xfbff7feffbff7fefULL,
    0xfdffefff7ffbffdfULL,
    0xff7fff7fff7fff7fULL,
    0xffefffff7ffffbffULL,
    0xffff7fffffff7fffULL,
    0xffffffff7fffffffULL,
    0xffffffffffffffffULL,
};
