jonasnic/Dreimaskin-ELS/(commit log)

2026-04-02 Initial Stepper Works
2026-04-03 Implement stepper motor control and encoder setup with RMT integration
2026-04-04 Adjust maximum speed and deceleration parameters for stepper motor control
2026-04-04 Refactor motion control and RMT setup: - Update setupRMT function to include a callback parameter. - Enhance motionTask to manage current position and target movement. - Introduce utility functions f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
2026-04-05 Adjust stepper motor parameters and enhance motion control logic
    todo: move dir_change to inside updatespeed to make sure i do it when its stopped
2026-04-08 some foramting. mainly fixed how to fill the buffer. and changed the rmt setup/start
    [rmt_setup.cpp]
2026-04-10 This is a basic working version
    [Book2.xlsx]
2026-04-10 just added the exel i just to make the bitpatern
    [Book2.xlsm]
2026-04-10 removed old file
    [Book2.xlsx]
2026-04-10 project cleanup. put all code in software folder. i can now make folder for hw
    [Book2.xlsm]
2026-04-12 started a kicadproject
    Add ESP32 Dev V1 symbol and associated library files
    - Created a new symbol library for the ESP32_DEV_V1 component, including properties for Reference, Value, Footprint, Datasheet, and Description.
    - Added a footprint library table entry for the ESP32 development kit.
    - Updated the symbol library table to include the new ESP32_DEV_V1 symbol and a legacy library entry.
    [ELS_project.kicad_pcb, ELS_project.kicad_sch]
2026-04-13 ordered the PCB
    [BOM-ELS_project.csv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]
2026-04-21 Refactor encoder and motion task logic to improve accuracy and performance; add current sensor functionality
2026-04-28 Refactor motion control and enhance UI integration
    - Updated motion_task.cpp to improve motion handling and direction control.
    - Introduced new RMT functions in rmt.cpp for better pulse generation and buffer management.
    - Modified utils.cpp and utils.h to support signed frequency handling.
    - Enhanced the MQTT GUI in app.py to include controls for stepper enable/disable and pitch settings.
    - Added new status indicators for RPM, alarm state, loop time, and batch time in the GUI.
    - Improved data reporting and handling of UI updates in motion_task.cpp.
2026-04-28 redesigned the powerstage sinse the org got realy hot. using newer parts
    [ELS_project.kicad_pcb, ELS_project.kicad_sch, bom.csv, designators.csv, positions.csv]
2026-04-28 Add new Excel file for data analysis and reporting
    [Book2.xlsm, Book3 (version 1).xlsx]
2026-05-03 Add FreeCAD project files and update MQTT management
    - Added new FreeCAD project files: ELS_project.FCStd, button.FCStd, encoder2.FCStd, and nextion_simp.FCStd along with their backup versions.
    - Refactored MQTT management in mqtt_manager.h and mqtt_manager.cpp:
    - Removed legacy task creation function and replaced it with a non-blocking service tick function.
    - Improved connection handling and initialization logic.
    - Updated reconnect interval to 3000 ms.
    - Enhanced command subscription handling using an array.
    - Updated UI task to call mqttServiceTick regularly.
    - Adjusted update rate to 3125 Hz for optimal performance.
    - Removed MQTT task creation from setup in main.cpp.
    - Updated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
    [Book3 (version 1).xlsx, ELS_project-AssemblyBack001.step, ELS_project-AssemblyFrontPanel001.step, ELS_project.FCStd, ELS_project.kicad_pcb, button.FCStd, encoder2.FCStd, nextion_simp.FCStd]
2026-05-08 Refactor UI button handling and improve command parsing; add debounce logic for button presses
    [nextion_simp.FCStd]
